HenrikMeid/DPTechnics-Walter-GPS-Boat_Tracker/Webserver/figures/platine_3d.png

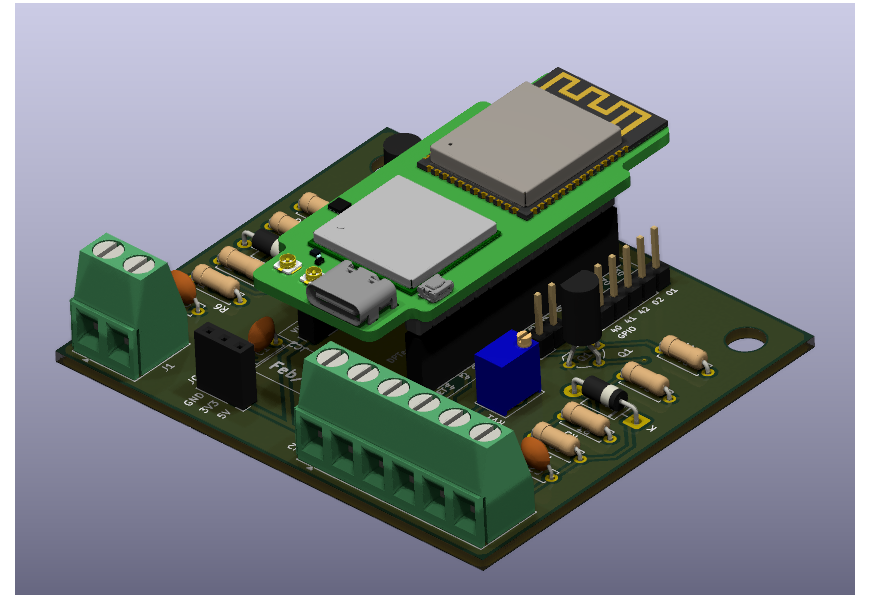
Webserver/figures/platine_3d.png
