HenrikMeid/DPTechnics-Walter-GPS-Boat_Tracker/Webserver/figures/schematic_gpios.pdf

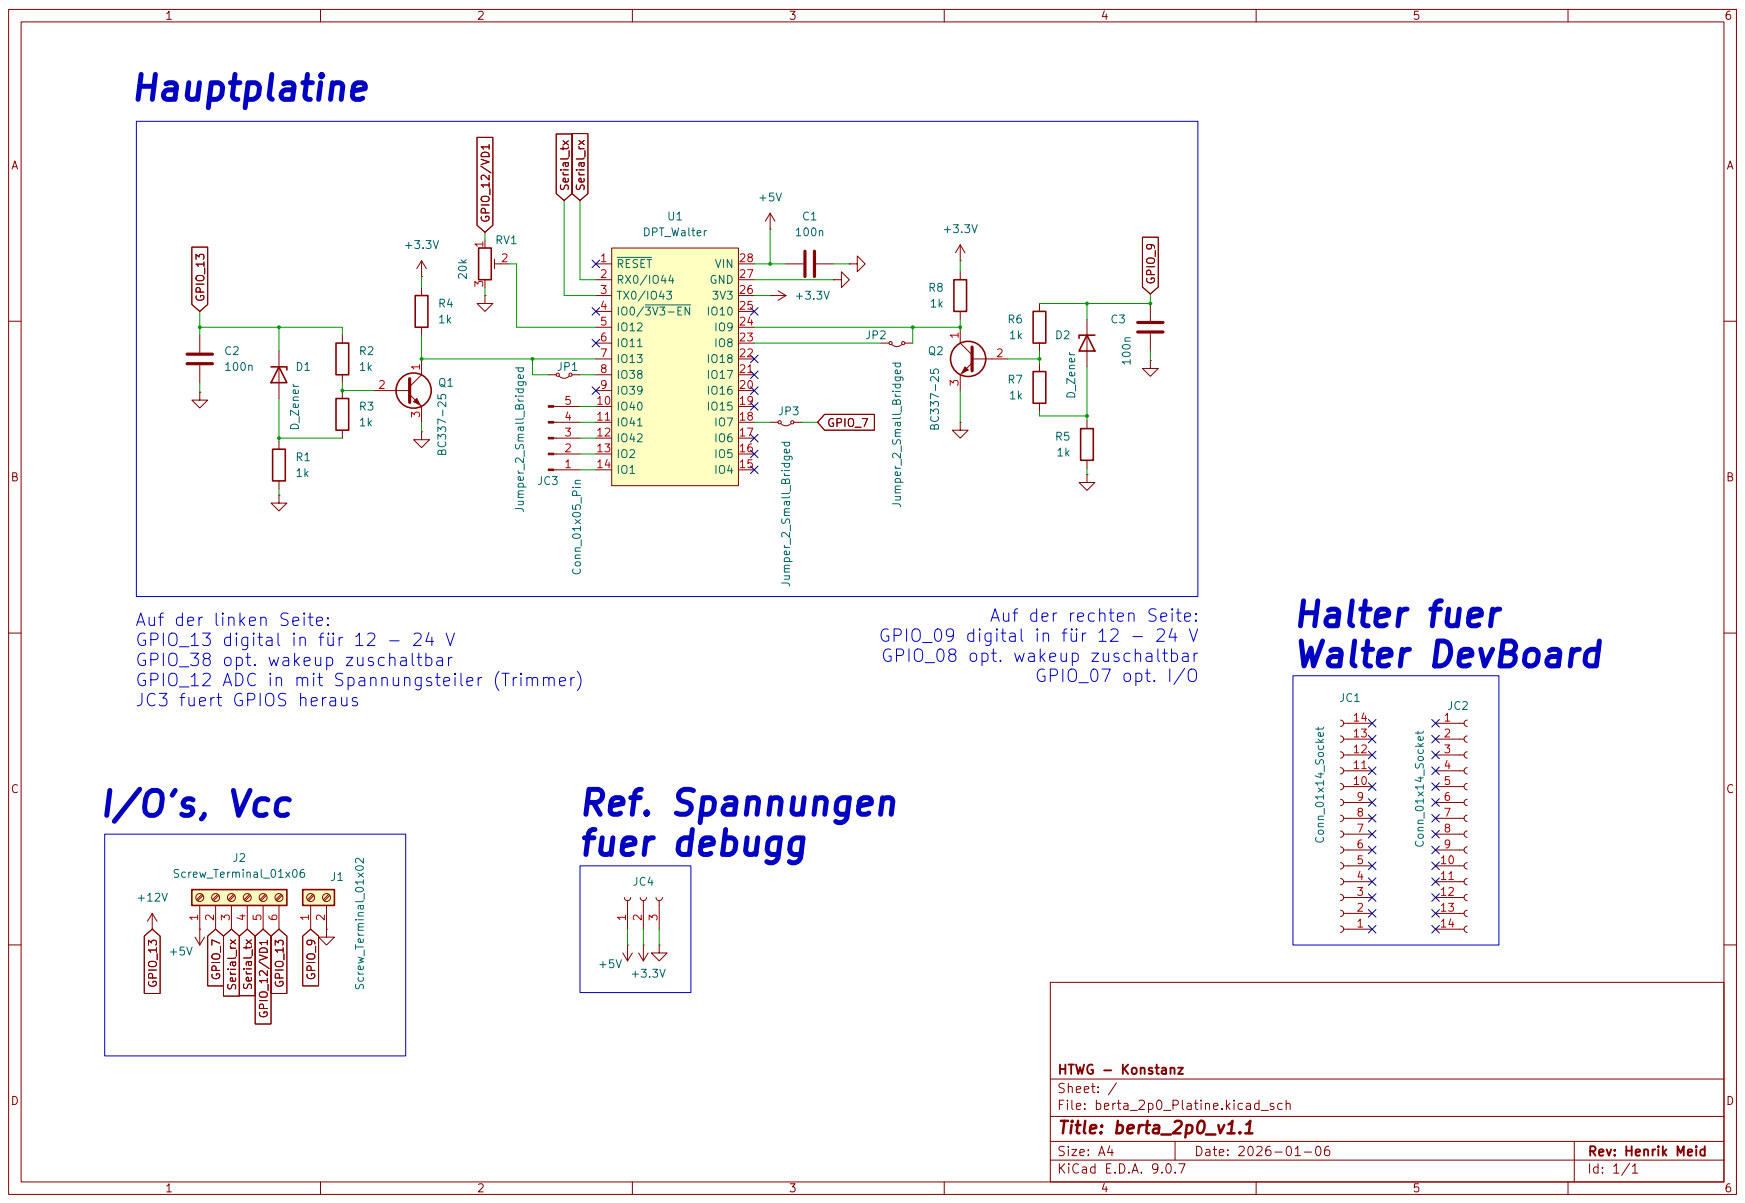
[picture p10: page 1]
