HenrikMeid/DPTechnics-Walter-GPS-Boat_Tracker/Platine/KiCAD/berta_2p0_Platine.kicad_pcb

## KiCad design Platine/KiCAD/berta_2p0_Platine.kicad_pcb (2026-06-26)

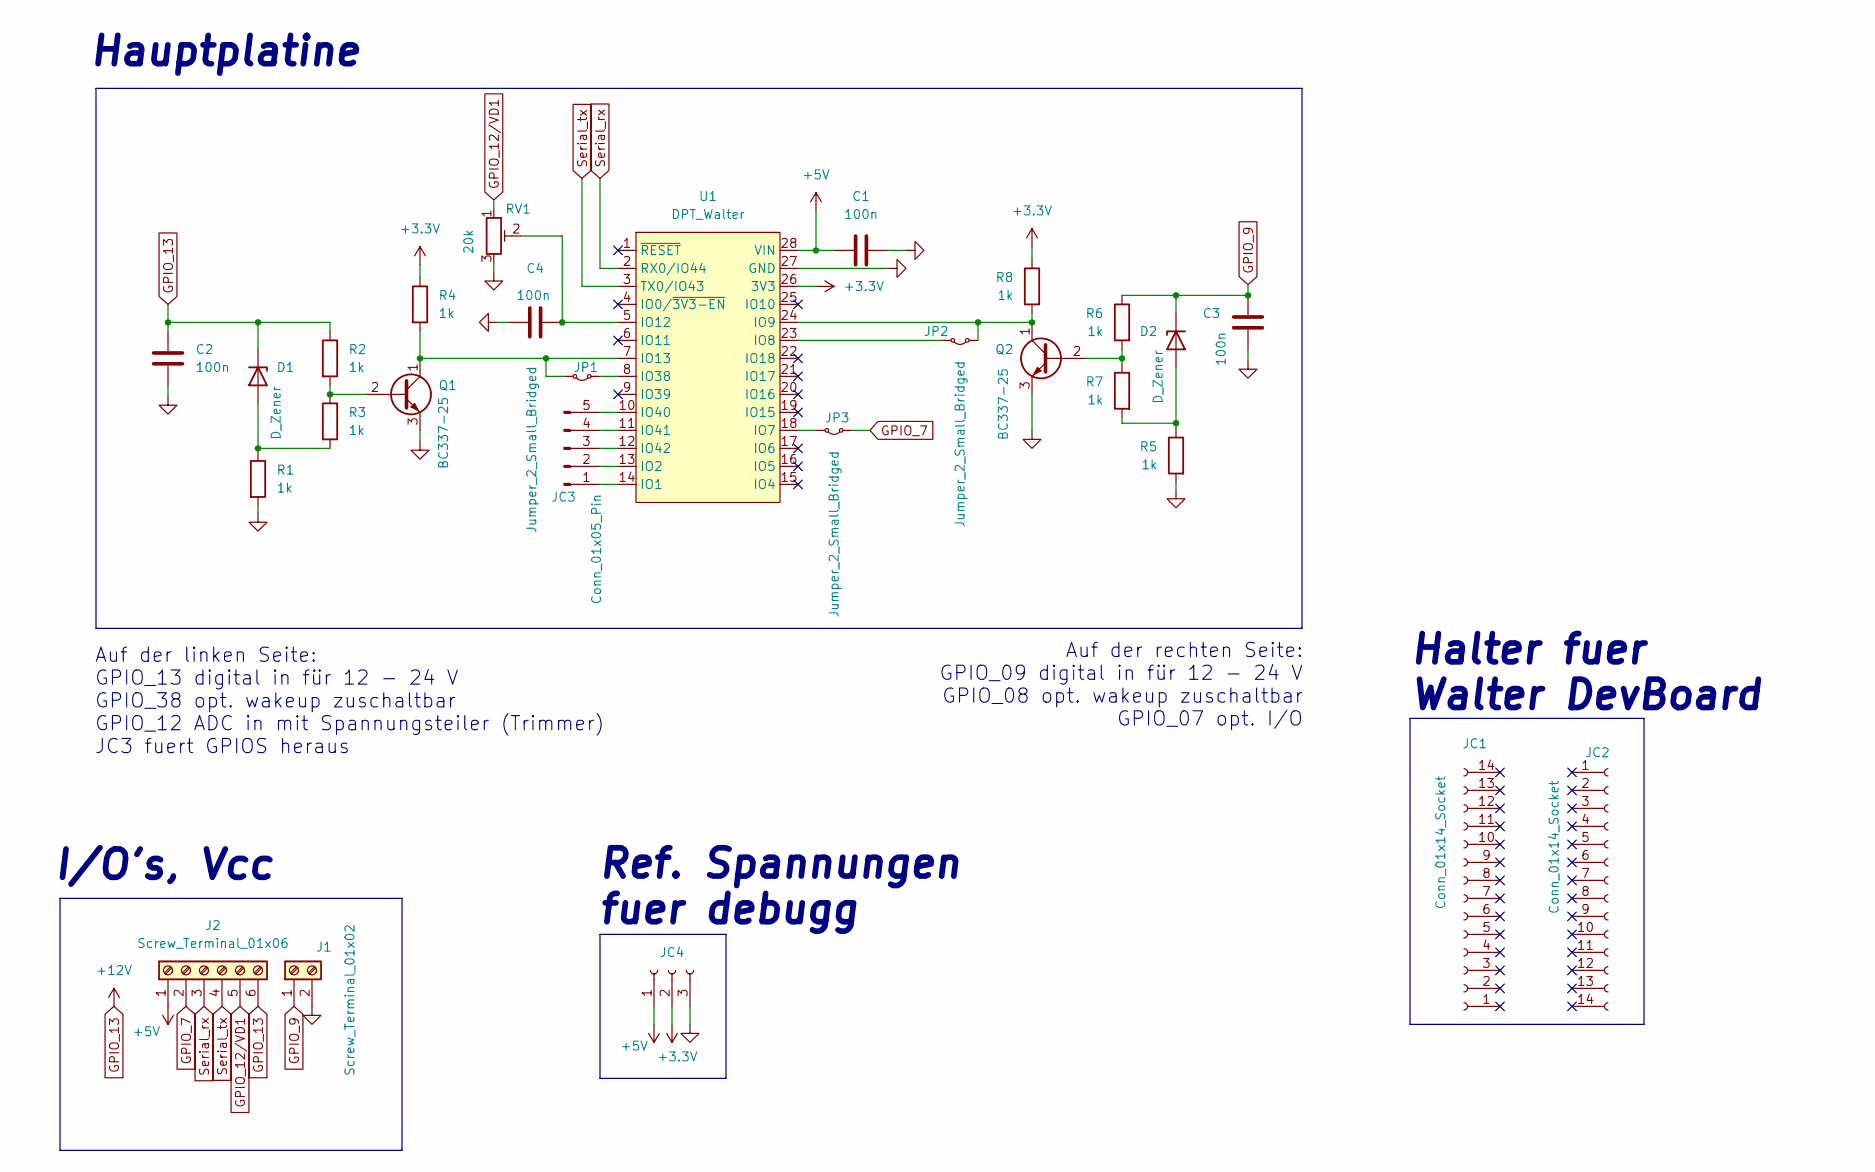
[picture p11: schematic berta_2p0_Platine.kicad_sch, berta_2p0_v1.1]

Parts:
C1, C2, C3, C4: 100n; C_Disc_D4.7mm_W2.5mm_P5.00mm
D1, D2: D_Zener; D_A-405_P10.16mm_Horizontal
J1: Screw_Terminal_01x02; TerminalBlock_Phoenix_MKDS-1,5-2_1x02_P5.00mm_Horizontal
J2: Screw_Terminal_01x06; TerminalBlock_Phoenix_MKDS-1,5-6_1x06_P5.00mm_Horizontal
JC1, JC2: Conn_01x14_Socket; PinSocket_1x14_P2.54mm_Vertical
JC3: Conn_01x05_Pin; PinHeader_1x05_P2.54mm_Vertical
JC4: Conn_01x03_Socket; PinSocket_1x03_P2.54mm_Vertical
JP1, JP2: Jumper_2_Small_Bridged; PinHeader_1x02_P2.54mm_Vertical
JP3: Jumper_2_Small_Bridged; SolderJumper-3_P1.3mm_Bridged2Bar12_Pad1.0x1.5mm
Q1, Q2: BC337-25; TO-92L_Wide
R1, R2, R3, R4, R5, R6, R7, R8: 1k; R_Axial_DIN0207_L6.3mm_D2.5mm_P7.62mm_Horizontal
RV1: 20k; Potentiometer_Runtron_RM-063_Horizontal
U1: DPT_Walter; walter-socket

Connections:
+3.3V: JC4.2, R4.1, R8.1, U1.26 (3V3)
+5V: C1.2, J2.1, JC4.1, U1.28 (VIN)
GND: C1.1, C2.2, C3.2, C4.2, J1.2, JC4.3, Q1.3 (E), Q2.3 (E), R1.2, R5.2, RV1.3, U1.27 (GND)
GPIO_7: J2.2, JP3.2 (B)
GPIO_9: C3.1, D2.1 (K), J1.1, R6.1
GPIO_12/VD1: J2.5, RV1.1
GPIO_13: C2.1, D1.1 (K), J2.6, R2.1
unnamed: D1.2 (A), R1.1, R3.2
unnamed: D2.2 (A), R5.1, R7.2
unnamed: JC3.1, U1.14 (IO1)
unnamed: JC3.2, U1.13 (IO2)
unnamed: JC3.3, U1.12 (IO42)
unnamed: JC3.4, U1.11 (IO41)
unnamed: JC3.5, U1.10 (IO40)
unnamed: JP1.1 (A), U1.8 (IO38)
unnamed: JP1.2 (B), Q1.1 (C), R4.2, U1.7 (IO13)
unnamed: JP2.1 (A), U1.23 (IO8)
unnamed: JP2.2 (B), Q2.1 (C), R8.2, U1.24 (IO9)
unnamed: JP3.1 (A), U1.18 (IO7)
unnamed: Q1.2 (B), R2.2, R3.1
unnamed: Q2.2 (B), R6.2, R7.1
unnamed: C4.1, RV1.2, U1.5 (IO12)
Serial_rx: J2.3, U1.2 (RX0/IO44)
Serial_tx: J2.4, U1.3 (TX0/IO43)

Notes on the sheet:
I/O's, Vcc
Halter fuer Walter DevBoard
Hauptplatine
Ref. Spannungen fuer debugg
Auf der rechten Seite: GPIO_09 digital in für 12 - 24 V GPIO_08 opt. wakeup zuschaltbar GPIO_07 opt. I/O
Auf der linken Seite: GPIO_13 digital in für 12 - 24 V GPIO_38 opt. wakeup zuschaltbar GPIO_12 ADC in mit Spannungsteiler (Trimmer) JC3 fuert GPIOS heraus

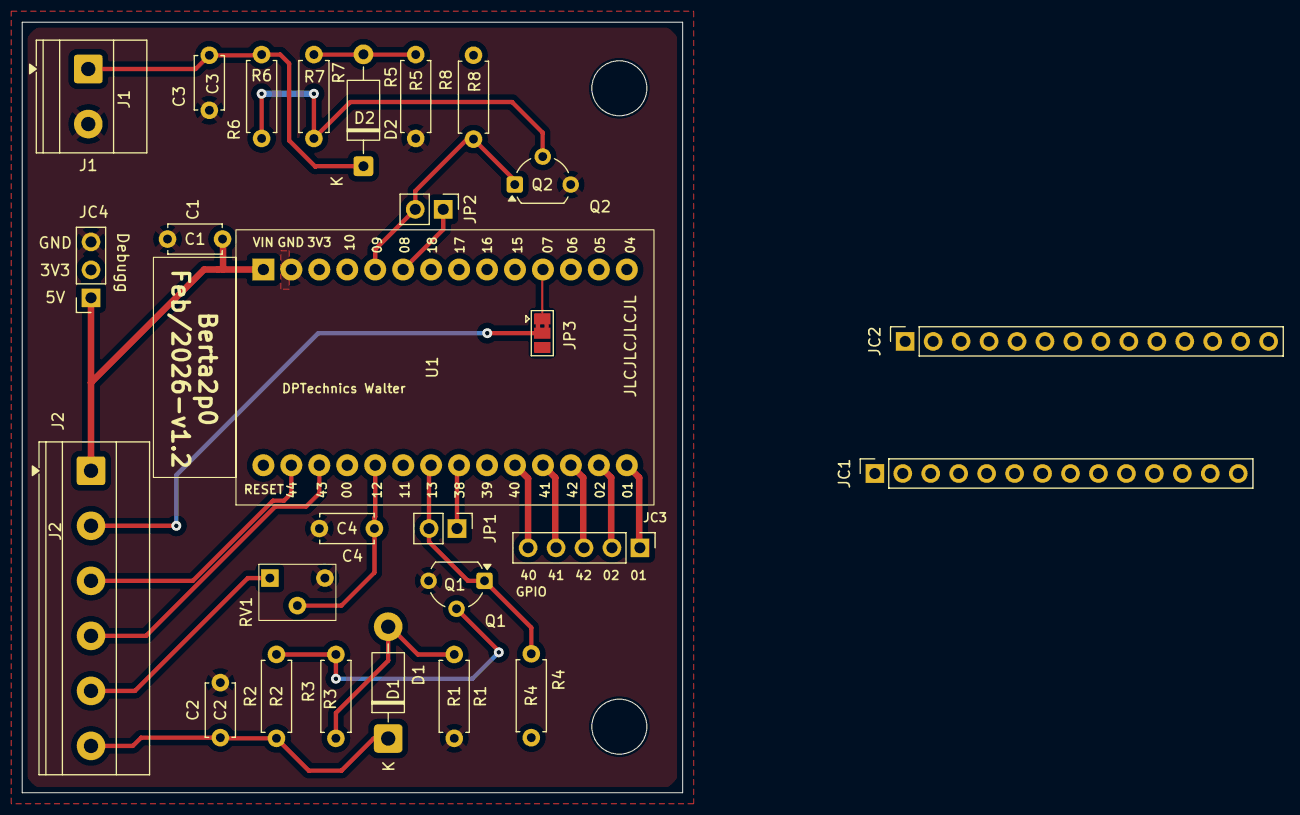
[picture p12: board berta_2p0_Platine.kicad_pcb from above]

Board: 2 copper layers, 60.0 x 70.0 mm, 27 parts (0 on the bottom side), 24 nets.
